SophBG/pi-tin-mod/3d/faceplate/faceplate_preview.png

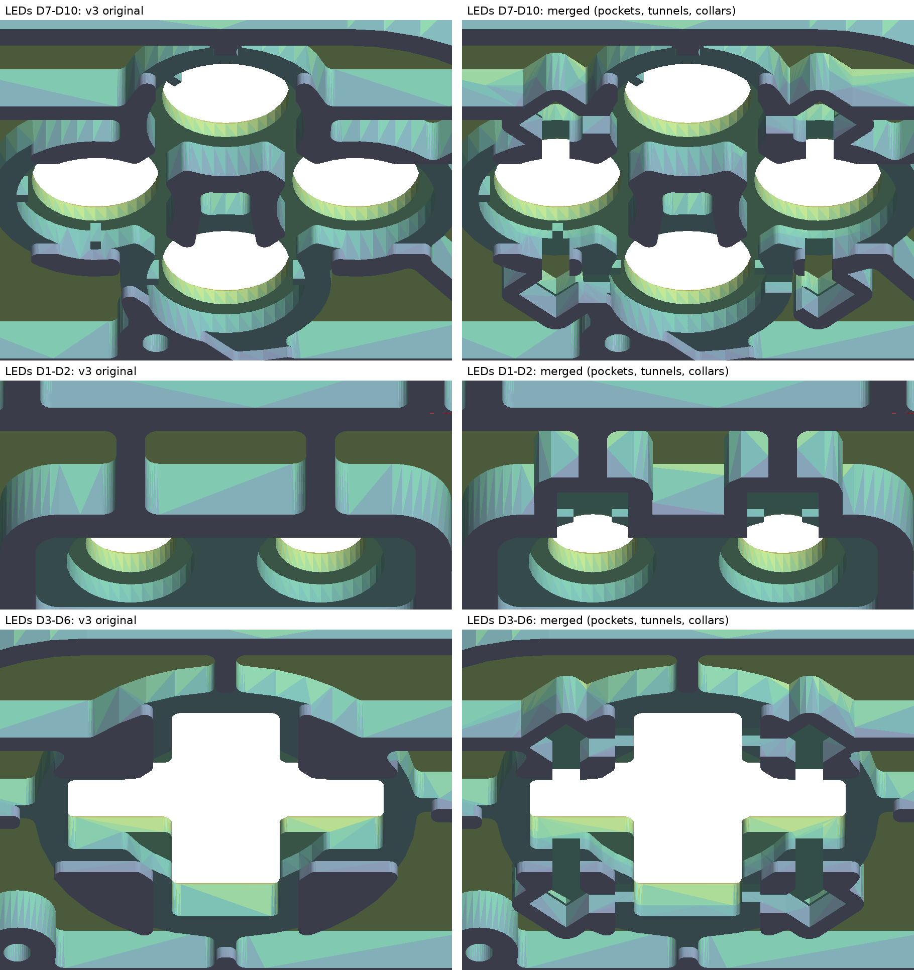
3d/faceplate/faceplate_preview.png
