SophBG/pi-tin-mod/images/variant_comparison.png

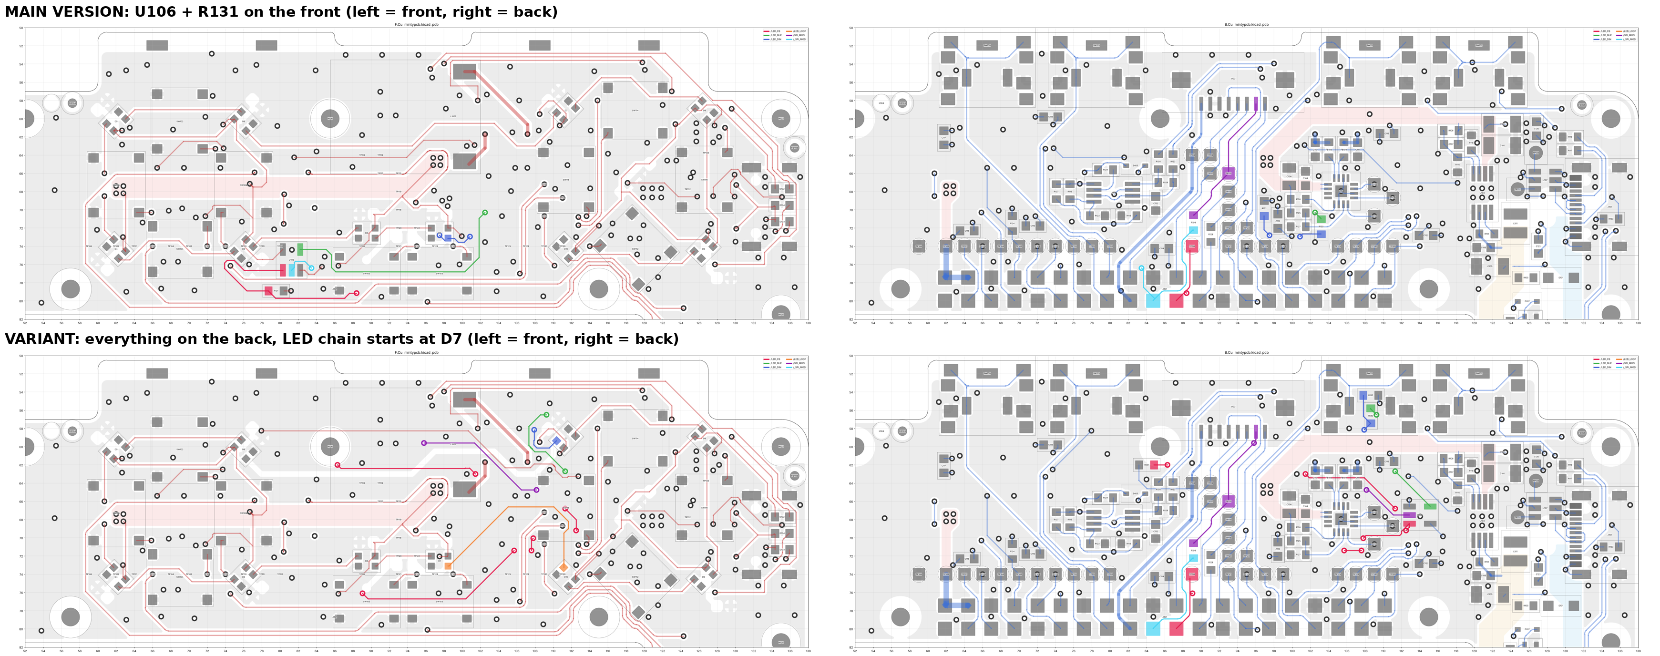
images/variant_comparison.png
