SophBG/pi-tin-mod/software/orange_pi/overlay/ask-card-en.png

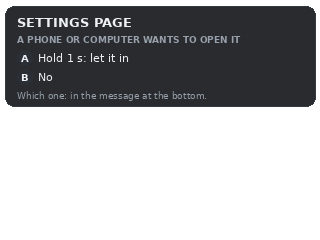
software/orange_pi/overlay/ask-card-en.png
