SophBG/pi-tin-mod/software/orange_pi/overlay/ask-card-fr.png

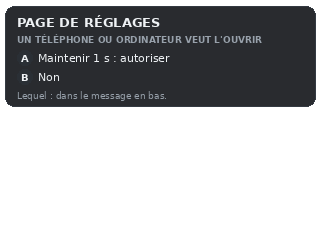
software/orange_pi/overlay/ask-card-fr.png
