SophBG/pi-tin-mod/software/orange_pi/overlay/help-card-en.png

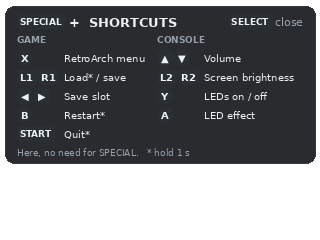
software/orange_pi/overlay/help-card-en.png
