SophBG/pi-tin-mod/software/orange_pi/overlay/help-card-fr.png

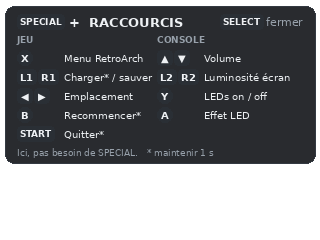
software/orange_pi/overlay/help-card-fr.png
