SophBG/pi-tin-mod/bom/1_set/BOM_comparison.csv

Item | Description | References (per board) | Qty needed (1 set) | LCSC: code (MPN) | LCSC: qty to order | LCSC: total € | LCSC: note | Mouser FR: code (MPN) | Mouser: qty to order | Mouser: total € | Mouser: note | DigiKey FR: code (MPN) | DigiKey: qty to order | DigiKey: total € | DigiKey: note
C22u | Ceramic capacitor 22 µF 10 V X7R 1206 | C101,C102,C105 | 3 | C87996 (CL31B226KPHNNNE) | 5 | 0.76 |  | 187-CL31B226KPHNNNE (CL31B226KPHNNNE) | 3 | 1.29 |  | 1276-2769-1-ND (CL31B226KPHNNNE) | 3 | 1.34
C10u | Ceramic capacitor 10 µF X7R 0805 (≥10 V) | C103,C104,C108 + display C101 | 4 | C32635 (CL21B106KPQNNNE) | 10 | 0.83 |  | 187-CL21B106KPQNNNG (CL21B106KPQNNNG) | 4 | 1.17 | same capacitor as the schematic (the NNNE packaging is out of stock at Mouser) | 1276-2872-1-ND (CL21B106KOQNNNE) | 4 | 0.97 | 16 V version of the same capacitor (the 10 V one is out of stock)
C100n | Ceramic capacitor 100 nF 50 V X7R 0603 | C106,C109,C112,C113-C122 | 13 | C14663 (CC0603KRX7R9BB104) | 50 | 0.55 |  | 603-CC603KRX7R9BB104 (CC0603KRX7R9BB104) | 13 | 0.82 |  | 399-C0603C104K5RACTUCT-ND (C0603C104K5RACTU) | 13 | 0.90 | direct equivalent (the YAGEO part is out of stock at DigiKey)
WS2812 | Addressable RGB LED, 2020 size, WS2812B-2020 compatible (2×2 mm) | D1-D10 | 10 | C5349955 (XL-2020RGBC-WS2812B) | 10 | 1.00 | Worldsemi WS2812B-2020 (C965555) is no longer available; same pinout (DO, GND, DI, VDD), 2.0×2.0×0.65 mm, 5 mA per colour | 485-4684 (4684) | 1 | 3.40 | pack of 10 WS2812B-2020 LEDs | 1528-4684-ND (4684) | 1 | 3.53 | pack of 10 WS2812B-2020 LEDs
D101 | Schottky diode 100 V 1 A SOD-123F | D101 | 1 | C64888 (DSK110) | 50 | 0.86 |  | 771-PMEG10010ELRX (PMEG10010ELRX) | 1 | 0.39 | 100 V 1 A, lower Vf; SOD-123W (CFP3) body fits the SOD-123F pads | MBR1H100SFT3GOSCT-ND (MBR1H100SFT3G) | 1 | 0.59 | 100 V 1 A, SOD-123FL (same pads)
LEDor | Orange LED 0603 | D102 | 1 | C157740 (LTST-C190KFKT) | 50 | 0.88 |  | 859-LTST-C190KFKT (LTST-C190KFKT) | 1 | 0.12 |  | 160-1434-1-ND (LTST-C190KFKT) | 1 | 0.13
LEDgr | Green LED 0603 | D104 | 1 | C364559 (LTST-C190TGKT) | 20 | 0.75 |  | 859-LTST-C190TGKT (LTST-C190TGKT) | 1 | 0.39 |  | 160-2019-1-ND (LTST-C190TGKT) | 1 | 0.40
BAT54 | Schottky diode BAT54WS 30 V SOD-323 | D105,D106,D107 | 3 | C124205 (BAT54WS-7-F) | 10 | 0.57 |  | 621-BAT54WS-F (BAT54WS-7-F) | 3 | 0.57 |  | BAT54WS-TPCT-ND (BAT54WS-TP) | 3 | 0.46 | same BAT54WS SOD-323 (the Diodes Inc. part is out of stock)
F101 | SMD fuse 1 A fast-acting 0603 | F101 | 1 | C151139 (0467001.NRHF) | 10 | 0.46 |  | 504-CC06FA1A-TR (CC06FA1A-TR) | 1 | 0.30 | 1 A 63 V fast-acting 0603; 1/4 of the Littelfuse price (1.34 €) | SF-0603F100-2CT-ND (SF-0603F100-2) | 1 | 0.82 | 1 A fast-acting 0603; half the Littelfuse price ($1.81)
USBC | USB-C receptacle 16 pins SMD (USB 2.0) | J101 | 1 | C2894897 (HC-TYPE-C-16P-01A) | 5 | 0.38 |  | 640-USB4105-GF-A (USB4105-GF-A) | 1 | 0.69 | fits the adapted board directly (pitin_extra footprint accepts HCTL and GCT) | 2073-USB4105-GF-ACT-ND (USB4105-GF-A) | 1 | 0.72 | fits the adapted board directly (pitin_extra footprint accepts HCTL and GCT)
JST | JST PH 2-pin SMD side-entry connector (battery) | J102 | 1 | C295747 (S2B-PH-SM4-TB(LF)(SN)) | 5 | 1.07 |  | 306-S2BPHSM4KTBLFSN (S2B-PH-SM4-K-TB(LF)(SN)) | 1 | 0.47 | same connector with black housing (the beige one is out of stock until 13/10) | 455-S2B-PH-SM4-TBCT-ND (S2B-PH-SM4-TB(LF)(SN)) | 1 | 0.44
FPC8 | FPC connector 8 pos 1.0 mm pitch, bottom contact (inter-board cable) | J103 + display J102 | 2 | C19269923 (FPC09-Q1.0-8AH2.0) | 5 | 0.39 |  | 538-200528-0080 (200528-0080) | 2 | 1.03 | same body as the XYECONN; fits the adapted board directly (tab pads widened) | WM17815CT-ND (2005280080) | 2 | 1.20 | same body as the XYECONN; fits the adapted board directly (tab pads widened)
FPC50 | FPC connector 50 pos 0.5 mm pitch, top contact, slide lock (display panel) | display J103 | 1 | C262650 (AFC07-S50ECA-00) | 5 | 1.30 |  | 649-F32Q-1A7H1-11050 (F32Q-1A7H1-11050) | 1 | 2.00 | same type (top contact, 2.0 mm high); pins line up and the tabs land inside the pads | 609-F32Q-1A7H1-11050CT-ND (F32Q-1A7H1-11050) | 1 | 2.08 | same type (top contact, 2.0 mm high); pins line up and the tabs land inside the pads
L101 | Inductor 2.2 µH 3.2×2.5 mm (1210), Isat ≥ 3 A | L101 | 1 | C5832385 (FTC322512S2R2MBCA) | 5 | 1.36 |  | 81-DFE322512F-2R2MP2 (DFE322512F-2R2M=P2) | 1 | 0.42 | same 3225×1.2 mm size | 490-DFE322512F-2R2M=P2CT-ND (DFE322512F-2R2M=P2) | 1 | 0.44 | same 3225×1.2 mm size
Q3415 | P-channel MOSFET 20 V ~4 A SOT-23 (AO3415A type) | Q101,Q102 | 2 | C133233 (AO3415A) | 5 | 0.47 | the "3415A" in the schematic (C337518) is discontinued; AO3415A is the original part | 621-DMG3415U-7 (DMG3415U-7) | 2 | 0.89 | equivalent (20 V, 4 A, 42 mΩ); Mouser does not sell the AO3415A | 4518-AO3415ACT-ND (AO3415A) | 2 | 0.86
BSS138 | N-channel MOSFET BSS138W SOT-323 | Q103 | 1 | C24553 (BSS138W-7-F) | 5 | 1.21 |  | 771-BSS138BKW115 (BSS138BKW,115) | 1 | 0.28 | 60 V SOT-323 equivalent (Diodes BSS138W out of stock; Mouser does not sell the MCC one in France) | BSS138W-TPMSCT-ND (BSS138W-TP) | 1 | 0.23
NMOS_disp | N-channel MOSFET 20 V SOT-323, logic level (backlight) | display Q101 | 1 | C110101 (CJ3134KW) | 20 | 0.59 |  | 621-DMN2004WK-7 (DMN2004WK-7) | 1 | 0.49 | equivalent: 20 V 0.54 A, Vgs(th) ≤ 1 V | DMN2004WKDICT-ND (DMN2004WK-7) | 1 | 0.51 | equivalent: 20 V 0.54 A, Vgs(th) ≤ 1 V
R10k | Resistor 10 kΩ 1% 0603 | R101,R111,R121,R131 + display R104 | 5 | C98220 (RC0603FR-0710KL) | 100 | 0.30 | the UNI-ROYAL C25804 is out of stock | 603-RC0603FR-0710KL (RC0603FR-0710KL) | 10 | 0.12 |  | 311-10.0KHRCT-ND (RC0603FR-0710KL) | 10 | 0.22
R22 | Resistor 22 Ω 1% 0603 | R104,R128 | 2 | C23345 (0603WAF220JT5E) | 100 | 0.15 |  | 603-RC0603FR-0722RL (RC0603FR-0722RL) | 10 | 0.10 |  | RMCF0603FT22R0CT-ND (RMCF0603FT22R0) | 2 | 0.18
R1k69 | Resistor 1.69 kΩ 1% 0603 | R105,R110,R114,R120 | 4 | C22846 (0603WAF1691T5E) | 100 | 0.43 |  | 603-RC0603FR-071K69L (RC0603FR-071K69L) | 10 | 0.12 |  | 311-1.69KHRCT-ND (RC0603FR-071K69L) | 10 | 0.22
R100k | Resistor 100 kΩ 1% 0603 | R106,R112,R113,R115,R122,R127,R129,R132,R133,R134 | 10 | C25803 (0603WAF1003T5E) | 100 | 0.28 |  | 603-RC0603FR-07100KL (RC0603FR-07100KL) | 10 | 0.12 |  | 311-100KHRCT-ND (RC0603FR-07100KL) | 10 | 0.22
R49k9 | Resistor 49.9 kΩ 1% 0603 | R107 | 1 | C23184 (0603WAF4992T5E) | 100 | 0.73 |  | 603-RC0603FR-0749K9L (RC0603FR-0749K9L) | 1 | 0.09 |  | 311-49.9KHRCT-ND (RC0603FR-0749K9L) | 1 | 0.09
R750k | Resistor 750 kΩ 1% 0603 | R108,R126 | 2 | C23240 (0603WAF7503T5E) | 100 | 0.24 |  | 708-RMCF0603FT750K (RMCF0603FT750K) | 10 | 0.10 |  | RMCF0603FT750KCT-ND (RMCF0603FT750K) | 2 | 0.18
R5k1 | Resistor 5.1 kΩ 1% 0603 | R116,R117,R123,R124 | 4 | C23186 (0603WAF5101T5E) | 100 | 0.13 |  | 603-RC0603FR-075K1L (RC0603FR-075K1L) | 10 | 0.15 |  | RMCF0603FT5K10CT-ND (RMCF0603FT5K10) | 10 | 0.19
R68k | Resistor 68 kΩ 1% 0603 | R119 | 1 | C23231 (0603WAF6802T5E) | 100 | 0.14 |  | 603-RC0603FR-0768KL (RC0603FR-0768KL) | 1 | 0.09 |  | 311-68.0KHRCT-ND (RC0603FR-0768KL) | 1 | 0.09
R330 | Resistor 330 Ω 1% 0603 | R130 | 1 | C23138 (0603WAF3300T5E) | 100 | 0.23 |  | 603-RC0603FR-07330RL (RC0603FR-07330RL) | 1 | 0.09 |  | 311-330HRCT-ND (RC0603FR-07330RL) | 1 | 0.09
R10 | Resistor 10 Ω 1% 0603 | display R101,R102,R103,R105 | 4 | C22859 (0603WAF100JT5E) | 20 | 0.06 |  | 708-RMCF0603FT10R0 (RMCF0603FT10R0) | 10 | 0.10 |  | RMCF0603FT10R0CT-ND (RMCF0603FT10R0) | 10 | 0.19
SKQG | Tactile switch Alps SKQGABE010 5.2×5.2 mm | SW101,SW103,SW105,SW115 | 4 | C115351 (SKQGABE010) | 5 | 0.56 |  | 688-SKQGAB (SKQGABE010) | 4 | 1.34 |  | 4809-SKQGABE010CT-ND (SKQGABE010) | 4 | 1.11
SKRR | Tactile switch Alps SKRRAAE010 (D-pad, ABXY) | SW102,SW104,SW106,SW108,SW110,SW112,SW114,SW116 | 8 | C97437 (SKRRAAE010) | 10 | 1.56 |  | 688-SKRRAA (SKRRAAE010) | 8 | 4.66 |  | 4809-SKRRAAE010CT-ND (SKRRAAE010) | 8 | 4.08
TL3336 | Side-actuated tactile switch E-Switch TL3336AF160Q (shoulder buttons, 3D printed case) | SW107,SW109,SW111,SW113 | 4 | C2979165 (TL3336AF160Q) | 4 | 2.09 |  | 612-TL3336AF160Q (TL3336AF160Q) | 4 | 1.48 |  | 141-TL3336AF160QCT-ND (TL3336AF160Q) | 4 | 1.68
LMV393 | Dual comparator LMV393 MSOP-8 | U101 | 1 | C460091 (LMV393M8-13) | 5 | 1.32 |  | 621-LMV393M8-13 (LMV393M8-13) | 1 | 0.33 |  | LMV393M8-13DICT-ND (LMV393M8-13) | 1 | 0.36
MCP73833 | Li-Po charger MCP73833-FCI DFN-10 3×3 | U102 | 1 | C511320 (MCP73833-FCI/MF) | 1 | 1.99 | same IC in a tube; the tape-and-reel version (C511337) is out of stock | 579-MCP73833T-FCI/MF (MCP73833T-FCI/MF) | 1 | 0.98 |  | MCP73833T-FCI/MFCT-ND (MCP73833T-FCI/MF) | 1 | 1.02
PAM2401 | Boost converter PAM2401SCADJ MSOP-8 | U103 | 1 | C508238 (PAM2401SCADJ) | 1 | 0.67 |  | 621-PAM2401SCADJ (PAM2401SCADJ) | 1 | 0.92 |  | PAM2401SCADJDICT-ND (PAM2401SCADJ) | 1 | 1.06
MAX98357 | I2S class-D amplifier MAX98357A TQFN-16 | U104 | 1 | C910544 (MAX98357AETE+T) | 1 | 1.19 |  | 700-MAX98357AETE+T (MAX98357AETE+T) | 1 | 3.51 |  | MAX98357AETE+TCT-ND (MAX98357AETE+T) | 1 | 3.65
AHCT125 | Buffer 74AHCT1G125 SOT-23-5 (LED data) | U106 | 1 | C7484 (SN74AHCT1G125DBVR) | 5 | 0.45 |  | 595-SNAHCT1G125DBVR (SN74AHCT1G125DBVR) | 1 | 0.12 |  | 296-4708-1-ND (SN74AHCT1G125DBVR) | 1 | 0.13
USBLC6 | ESD protection USBLC6-2SC6 SOT-23-6 | U107 | 1 | C7519 (USBLC6-2SC6) | 5 | 0.80 |  | 511-USBLC6-2SC6 (USBLC6-2SC6) | 1 | 0.42 |  | 497-5235-1-ND (USBLC6-2SC6) | 1 | 0.48
APX803 | Reset supervisor 3.08 V SOT-23 (display) | display U101 | 1 | C460552 (APX803-31SAG-7) | 5 | 1.03 |  | 621-APX803S-31SA-7 (APX803S-31SA-7) | 1 | 0.23 | newer version of the same IC (3.08 V, 240 ms) | APX803S-31SA-7DICT-ND (APX803S-31SA-7) | 1 | 0.29 | newer version of the same IC (3.08 V, 240 ms)
FFC | FFC cable 8 pos 1.0 mm pitch, 50 mm, contacts on the same side | extra: cable between the boards | 1 | C2857570 (JS10A-08P-050-4-8) | 5 | 0.40 | same type as the GCT: 1.0 mm, 8 pos, 5 cm, contacts on the same side | 640-1008A0050C4084T (10-08-A-0050-C-4-08-4-T) | 1 | 0.64 |  | 2073-10-08-A-0050-C-4-08-4-T-ND (10-08-A-0050-C-4-08-4-T) | 1 | 0.66
SPK | Speaker 15×11×2.5 mm 8 Ω 0.7 W, spring contacts (no soldering) | extra: LS101 | 1 | — |  |  | not available | 490-CMS-151125078S67 (CMS-151125-078S-67) | 1 | 2.17 | 8 Ω version of the original (6 Ω): same body, same spring contacts | 102-4998-ND (CMS-151125-078S-67) | 1 | 2.72 | 8 Ω version of the original (6 Ω): same body, same spring contacts
LCD | Display 2.8" TFT 240×320 ILI9341, 50-pin 0.5 mm FPC, resistive touch | extra: display panel | 1 | — |  |  | not available | 485-1774 (1774) | 1 | 15.44 | the panel of the original design (Multi-Inno MI0283QT-11) | — |  |  | not available
TOTAL (parts only, no shipping/taxes) |  |  |  |  |  | 28.18 |  |  |  | 48.02 |  |  |  | 34.50
