SophBG/pi-tin-mod/bom/1_set/BOM_Mouser_FR_speaker_display_only.csv

Mouser Part Number | Manufacturer Part Number | Manufacturer | Quantity | Description | Customer Part Number | Designators
490-CMS-151125078S67 | CMS-151125-078S-67 | Same Sky | 1 | Speaker 15×11×2.5 mm 8 Ω 0.7 W, spring contacts (no soldering) | PiTin SPK | extra: LS101
485-1774 | 1774 | Adafruit | 1 | Display 2.8" TFT 240×320 ILI9341, 50-pin 0.5 mm FPC, resistive touch | PiTin LCD | extra: display panel
