SophBG/pi-tin-mod/3d/case/p101_lower_case_fixed.STL

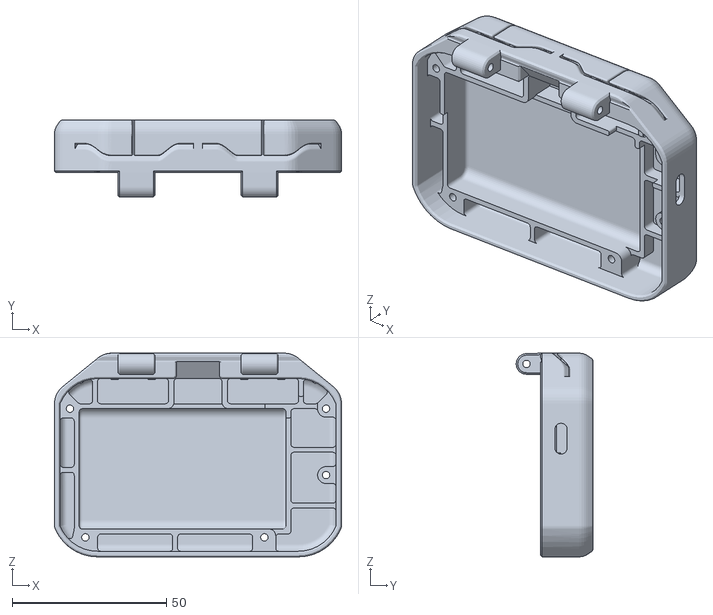
[picture p7: CAD file, 2026-10-13]
3d/case/p101_lower_case_fixed.STL
93.0 x 24.8 x 66.0
