SophBG/pi-tin-mod/3d/faceplate/faceplate_pocket_fill.stl

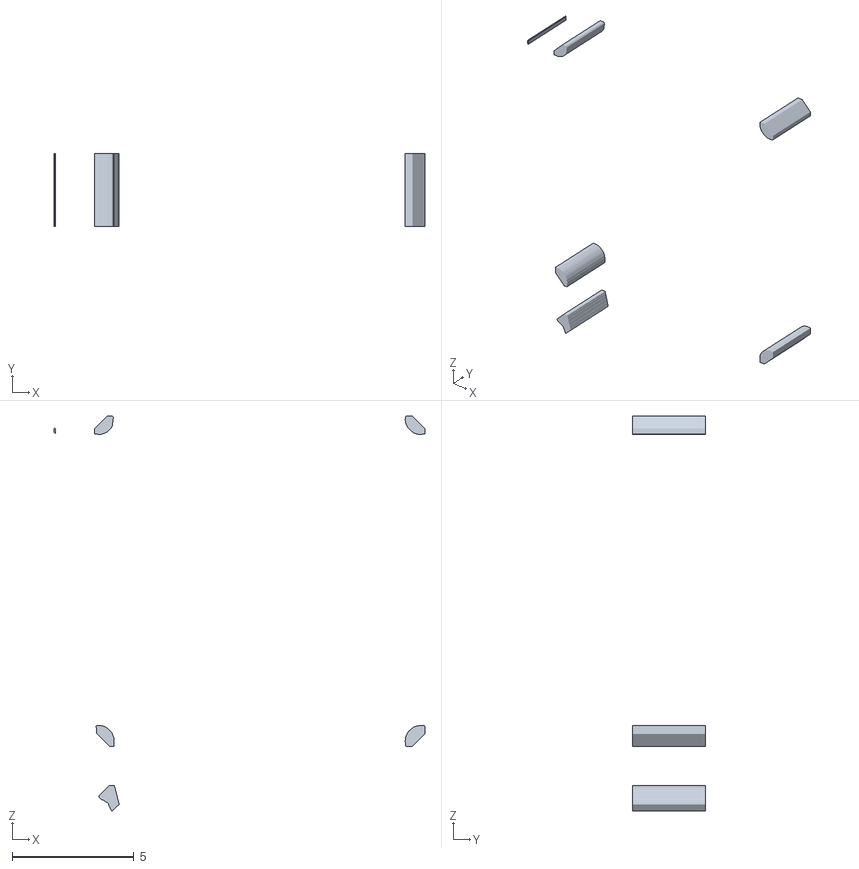
[picture p8: CAD file, 2026-10-17]
3d/faceplate/faceplate_pocket_fill.stl
15.2 x 3.00 x 16.3
