SophBG/pi-tin-mod/3d/faceplate/faceplate_v3_with_led_pockets.stl

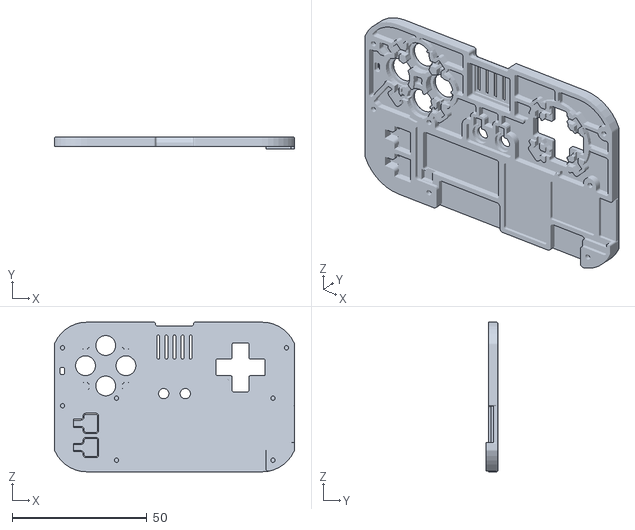
[picture p9: CAD file, 2026-10-17]
3d/faceplate/faceplate_v3_with_led_pockets.stl
89.0 x 4.60 x 55.5
