SophBG/pi-tin-mod/3d/faceplate/faceplate_thickening.stl

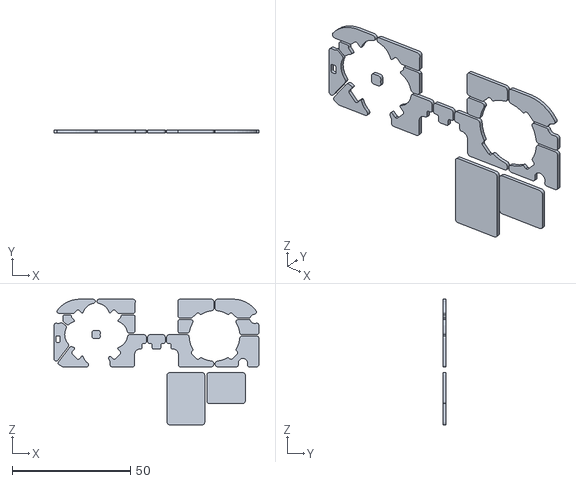
[picture p10: CAD file, 2026-10-17]
3d/faceplate/faceplate_thickening.stl
86.6 x 1.10 x 53.1
