SophBG/pi-tin-mod/3d/faceplate/faceplate_led_collars.stl

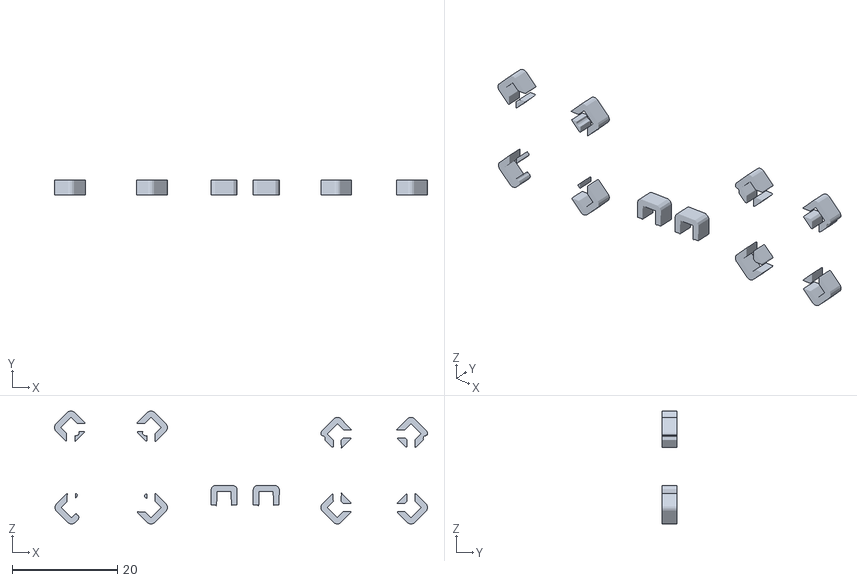
[picture p11: CAD file, 2026-10-13]
3d/faceplate/faceplate_led_collars.stl
70.9 x 2.90 x 21.5
