SophBG/pi-tin-mod/3d/faceplate/v3.stl

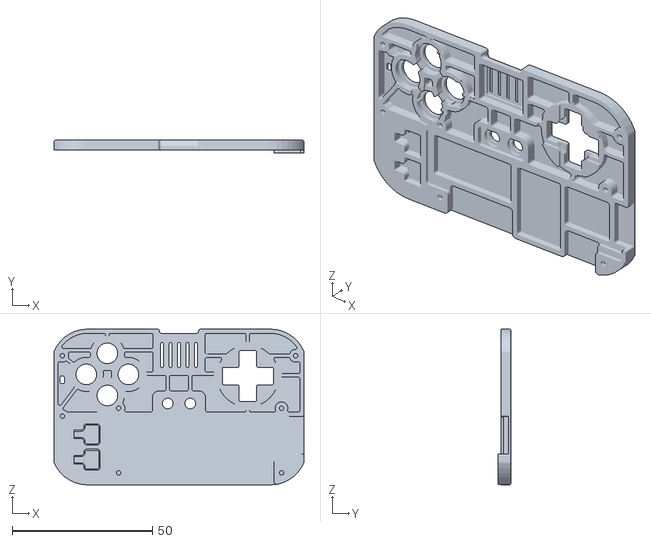
[picture p12: CAD file, 2026-10-13]
3d/faceplate/v3.stl
89.0 x 4.60 x 55.5
