SophBG/pi-tin-mod/3d/faceplate/faceplate_led_cutter.stl

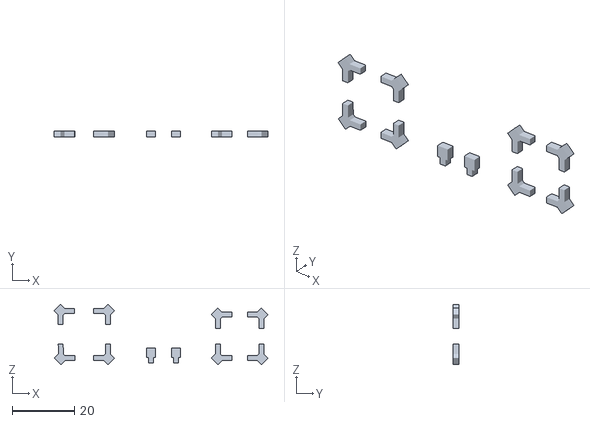
[picture p13: CAD file, 2026-10-13]
3d/faceplate/faceplate_led_cutter.stl
68.8 x 2.00 x 19.4
