SophBG/pi-tin-mod/kicad/pcb_main_r2/mintypcb.kicad_pcb

## KiCad design kicad/pcb_main_r2/mintypcb.kicad_pcb (2026-10-17)

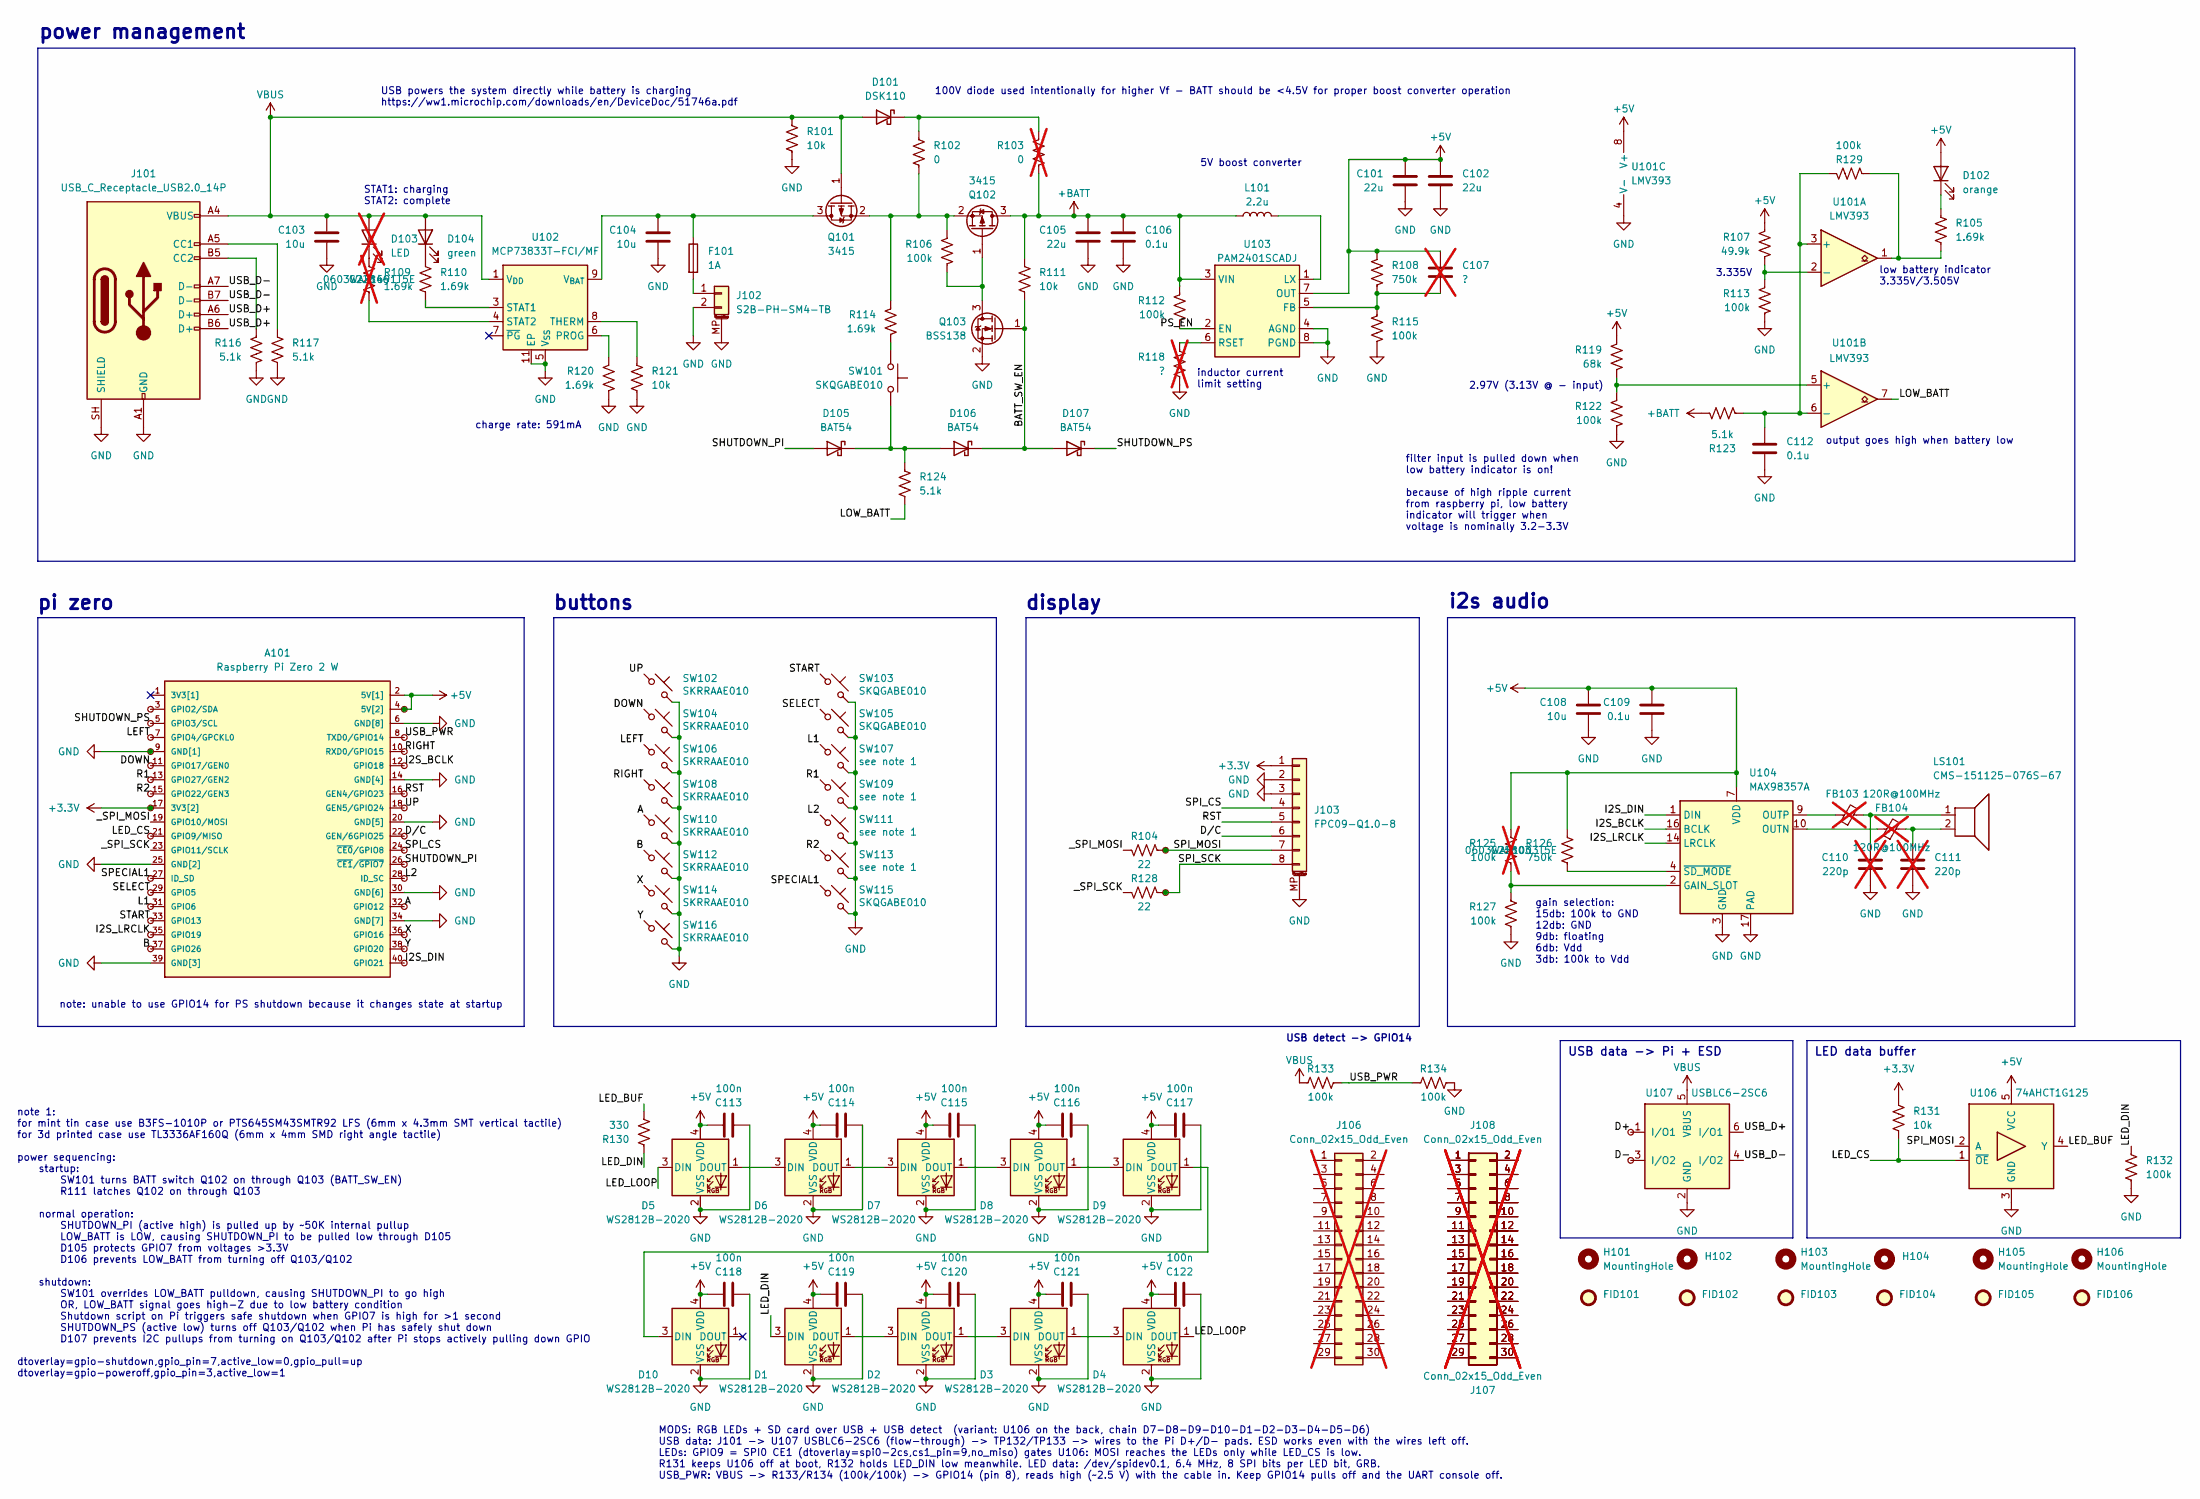
[picture p14: schematic mintypcb.kicad_sch, pi tin main pcb]

Parts:
A101: Raspberry Pi Zero 2 W; RASPBERRYPI-ZERO_RPI-ZERO_pi_tin; MPN (Alternate) SC1176
C101, C102, C105: 22u; C_1206_3216Metric; MPN CL31B226KPHNNNE; LCSC C87996
C103, C104, C108: 10u; C_0805_2012Metric; MPN CL21B106KPQNNNE; LCSC C32635
C106, C109, C112: 0.1u; C_0603_1608Metric; MPN CC0603KRX7R9BB104; LCSC C14663
C107: ?; C_0603_1608Metric; not fitted
C110, C111: 220p; C_0603_1608Metric; MPN (Alternate) CL10C221JB8NNNC; not fitted
C113, C114, C115, C116, C117, C118, C119, C120, C121, C122: 100n; C_0603_1608Metric; MPN CC0603KRX7R9BB104; LCSC C14663
D1, D2, D3, D4, D5, D6, D7, D8, D9, D10: WS2812B-2020; LED_WS2812B-2020_PLCC4_2.0x2.0mm
D101: DSK110; D_SOD-123F; MPN DSK110 K110; LCSC C64888
D102: orange; LED_0603_1608Metric; MPN LTST-C190KFKT; LCSC C157740
D103: LED; LED_0603_1608Metric; not fitted
D104: green; LED_0603_1608Metric; MPN LTST-C190TGKT; LCSC C364559
D105, D106, D107: BAT54; D_SOD-323; MPN BAT54WS-7-F; LCSC C124205
F101: 1A; Fuse_0603_1608Metric; MPN 0467001.NRHF; LCSC C151139
FB103, FB104: 120R@100MHz; R_0603_1608Metric_Bridged; MPN (Alternate) BLM18AG121SZ1D; not fitted
FID101, FID102, FID103, FID104, FID105, FID106: Fiducial_1mm_Mask2mm
H101, H103, H105, H106: MountingHole; MountingHole_2.2mm_M2_Mask_tight
H102, H104: ToolingHole; JLC_tooling_hole
J101: USB_C_Receptacle_USB2.0_14P; USB_C_Receptacle_HCTL_HC-TYPE-C-16P-01A_or_GCT_USB4105-GF-A
J102: S2B-PH-SM4-TB; JST_PH_S2B-PH-SM4-TB_1x02-1MP_P2.00mm_Horizontal; MPN S2B-PH-SM4-TB; LCSC C295747
J103: FPC09-Q1.0-8; FPC_1x08_P1.00mm_XYECONN_FPC09-Q1.0-8AH2.0_or_Molex_200528-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; MPN FPC09-Q1.0-8AH2.0; LCSC C19269923
J106: Conn_02x15_Odd_Even; pi_tin_pi_simulator; not fitted
J107: Conn_02x15_Odd_Even; pi_tin_pi_simulator_lands; not fitted
J108: Conn_02x15_Odd_Even; pi_tin_pi_simulator_tp; not fitted
L101: 2.2u; L_3225DFN; MPN FTC322512S2R2MBCA; LCSC C5832385
LS101: CMS-151125-076S-67; Speaker_CUI_CMR-1206S-67; MPN (Alternate) CMS-151125-076S-67
Q101, Q102: 3415; SOT-23; MPN 3415A; LCSC C337518
Q103: BSS138; SOT-323_SC-70; MPN BSS138W-7-F; LCSC C24553
R101, R111, R121, R131: 10k; R_0603_1608Metric; MPN 0603WAF1002T5E; LCSC C25804
R102: 0; R_0603_1608Metric_Bridged
R103: 0; R_0603_1608Metric; not fitted
R104, R128: 22; R_0603_1608Metric; MPN 0603WAF220JT5E; LCSC C23345
R105, R110, R114, R120: 1.69k; R_0603_1608Metric; MPN 0603WAF1691T5E; LCSC C22846
R106, R112, R113, R115, R122, R127, R129, R132, R133, R134: 100k; R_0603_1608Metric; MPN 0603WAF1003T5E; LCSC C25803
R107: 49.9k; R_0603_1608Metric; MPN 0603WAF4992T5E; LCSC C23184
R108, R126: 750k; R_0603_1608Metric; MPN 0603WAF7503T5E; LCSC C23240
R109: 1.69k; R_0603_1608Metric; MPN 0603WAF1691T5E; LCSC C22846; not fitted
R116, R117, R123, R124: 5.1k; R_0603_1608Metric; MPN 0603WAF5101T5E; LCSC C23186
R118: ?; R_0603_1608Metric; not fitted
R119: 68k; R_0603_1608Metric; MPN 0603WAF6802T5E; LCSC C23231
R125: 100k; R_0603_1608Metric; MPN 0603WAF1003T5E; LCSC C25803; not fitted
R130: 330; R_0603_1608Metric; MPN 0603WAF3300T5E; LCSC C23138
SW101, SW103, SW105, SW115: SKQGABE010; SW_PTS526; MPN SKQGABE010; LCSC C115351
SW102, SW104, SW106, SW108, SW110, SW112, SW114, SW116: SKRRAAE010; SW_SKRR; MPN SKRRAAE010; LCSC C97437
SW107, SW109, SW111, SW113: see note 1; SW_TL3336AF160Q_or_PTS645_paste1; MPN (Alternate) TL3336AF160Q; LCSC C231324
TP101, TP102, TP103, TP104, TP105, TP106, TP107, TP108, TP109, TP110, TP111, TP112, TP113, TP114, TP115, TP116, TP117, TP118, TP119, TP120, TP121, TP122, TP123, TP124, TP125, TP126, TP127, TP128, TP129, TP130, TP131: TestPoint_Small; TestPoint_Pad_D1.5mm
TP132: USB_D+; TestPoint_Pad_D1.5mm
TP133: USB_D-; TestPoint_Pad_D1.5mm
U101: LMV393; MSOP-8_3x3mm_P0.65mm; MPN LMV393M8-13; LCSC C460091
U102: MCP73833T-FCI/MF; DFN-10-1EP_3x3mm_P0.5mm_EP1.58x2.35mm; MPN MCP73833T-FCI/MF; LCSC C511337
U103: PAM2401SCADJ; MSOP-8_3x3mm_P0.65mm; MPN PAM2401SCADJ; LCSC C508238
U104: MAX98357A; TQFN-16-1EP_3x3mm_P0.5mm_EP1.23x1.23mm; MPN MAX98357AETE+T; LCSC C910544
U106: 74AHCT1G125; SOT-23-5; MPN SN74AHCT1G125DBVR; LCSC C7484
U107: USBLC6-2SC6; SOT-23-6; MPN USBLC6-2SC6; LCSC C7519

Connections:
+3.3V: A101.17 (3V3[2]), J103.1, R131.2, TP113.1 (1_1)
+5V: A101.2 (5V[1]), A101.4 (5V[2]), C101.1, C102.1, C107.1, C108.1, C109.1, C113.1, C114.1, C115.1, C116.1, C117.1, C118.1, C119.1, C120.1, C121.1, C122.1, D1.4 (VDD), D2.4 (VDD), D3.4 (VDD), D4.4 (VDD), D5.4 (VDD), D6.4 (VDD), D7.4 (VDD), D8.4 (VDD), D9.4 (VDD), D10.4 (VDD), D102.2 (A), R107.2, R108.1, R119.2, R125.1, R126.1, TP102.1 (1_1), U101.8 (V+), U103.7 (OUT), U104.7 (VDD), U104.8 (VDD), U106.5 (VCC)
+BATT: C105.1, C106.1, L101.1, Q102.3 (D), R103.1, R111.2, R112.2, R123.1, U103.3 (VIN)
/A: A101.32 (GPIO12), SW110.1, TP125.1 (1_1)
/B: A101.37 (GPIO26), SW112.1, TP129.1 (1_1)
/BATT_SW_EN: D106.1 (K), D107.2 (A), Q103.1 (G), R111.1
/D+: TP132.1, U107.1 (I/O1)
/D-: TP133.1, U107.3 (I/O2)
/DOWN: A101.11 (GPIO17/GEN0), SW104.1, TP108.1 (1_1)
/D/C: A101.22 (GEN/6GPIO25), J103.6, TP117.1 (1_1)
/I2S_BCLK: A101.12 (GPIO18), TP109.1 (1_1), U104.16 (BCLK)
/I2S_DIN: A101.40 (GPIO21), TP131.1 (1_1), U104.1 (DIN)
/I2S_LRCLK: A101.35 (GPIO19), TP127.1 (1_1), U104.14 (LRCLK)
/L1: A101.31 (GPIO6), SW107.1, TP124.1 (1_1)
/L2: A101.28 (ID_SC), SW111.1, TP122.1 (1_1)
/LED_BUF: R130.1, U106.4 (Y)
/LED_CS: A101.21 (GPIO9/MISO), R131.1, TP116.1 (1_1), U106.1 (~OE)
/LED_DIN: D1.3 (DIN), R130.2, R132.1
/LED_LOOP: D4.1 (DOUT), D5.3 (DIN)
/LEFT: A101.7 (GPIO4/GPCKL0), SW106.1, TP104.1 (1_1)
/LOW_BATT: R124.1, U101.7
/PS_EN: R112.1, U103.2 (EN)
/R1: A101.13 (GPIO27/GEN2), SW109.1, TP110.1 (1_1)
/R2: A101.15 (GPIO22/GEN3), SW113.1, TP111.1 (1_1)
/RIGHT: A101.10 (RXD0/GPIO15), SW108.1, TP107.1 (1_1)
/SELECT: A101.29 (GPIO5), SW105.1, TP123.1 (1_1)
/SHUTDOWN_PI: A101.26 (~CE1/~GPIO7), D105.2 (A), TP120.1 (1_1)
/SHUTDOWN_PS: A101.5 (GPIO3/SCL), D107.1 (K), TP103.1 (1_1)
/SPECIAL1: A101.27 (ID_SD), SW115.1, TP121.1 (1_1)
/SPI_CS: A101.24 (~CE0/GPIO8), J103.4, TP119.1 (1_1)
/SPI_MOSI: J103.7, R104.1, TP115.1 (1_1), U106.2 (A)
/SPI_SCK: J103.8, R128.1, TP118.1 (1_1)
/START: A101.33 (GPIO13), SW103.1, TP126.1 (1_1)
/USB_D+: J101.A6 (D+), J101.B6 (D+), U107.6 (I/O1)
/USB_D-: J101.A7 (D-), J101.B7 (D-), U107.4 (I/O2)
/USB_PWR: A101.8 (TXD0/GPIO14), R133.2, R134.1, TP105.1 (1_1)
/X: A101.36 (GPIO16), SW114.1, TP128.1 (1_1)
/Y: A101.38 (GPIO20), SW116.1, TP130.1 (1_1)
/_SPI_MOSI: A101.19 (GPIO10/MOSI), R104.2
/_SPI_SCK: A101.23 (GPIO11/SCLK), R128.2
GND: A101.6 (GND[8]), A101.9 (GND[1]), A101.14 (GND[4]), A101.20 (GND[5]), A101.25 (GND[2]), A101.30 (GND[6]), A101.34 (GND[7]), A101.39 (GND[3]), C101.2, C102.2, C103.2, C104.2, C105.2, C106.2, C108.2, C109.2, C110.2, C111.2, C112.2, C113.2, C114.2, C115.2, C116.2, C117.2, C118.2, C119.2, C120.2, C121.2, C122.2, D1.2 (VSS), D2.2 (VSS), D3.2 (VSS), D4.2 (VSS), D5.2 (VSS), D6.2 (VSS), D7.2 (VSS), D8.2 (VSS), D9.2 (VSS), D10.2 (VSS), J101.A1 (GND), J101.A12 (GND), J101.B1 (GND), J101.B12 (GND), J101.SH (SHIELD), J102.2, J102.MP (MountPin), J103.2, J103.3, J103.MP (MountPin), Q103.2 (S), R101.1, R113.1, R115.2, R116.1, R117.1, R118.2, R120.1, R121.1, R122.1, R127.2, R132.2, R134.2, SW102.2, SW103.2, SW104.2, SW105.2, SW106.2, SW107.2, SW108.2, SW109.2, SW110.2, SW111.2, SW112.2, SW113.2, SW114.2, SW115.2, SW116.2, TP106.1 (1_1), U101.4 (V-), U102.5 (V_{SS}), U102.11 (EP), U103.4 (AGND), U103.8 (PGND), U104.3 (GND), U104.11 (GND), U104.15 (GND), U104.17 (PAD), U106.3 (GND), U107.2 (GND)
unnamed: A101.3 (GPIO2/SDA), TP101.1 (1_1)
unnamed: C110.1, FB103.2, LS101.1
unnamed: C111.1, FB104.2, LS101.2
unnamed: D1.1 (DOUT), D2.3 (DIN)
unnamed: D2.1 (DOUT), D3.3 (DIN)
unnamed: D3.1 (DOUT), D4.3 (DIN)
unnamed: D5.1 (DOUT), D6.3 (DIN)
unnamed: D6.1 (DOUT), D7.3 (DIN)
unnamed: D7.1 (DOUT), D8.3 (DIN)
unnamed: D8.1 (DOUT), D9.3 (DIN)
unnamed: D9.1 (DOUT), D10.3 (DIN)
unnamed: D101.1 (K), R102.2, R103.2
unnamed: D102.1 (K), R105.2
unnamed: D103.1 (K), R109.2
unnamed: D104.1 (K), R110.2
unnamed: D105.1 (K), D106.2 (A), R124.2, SW101.1
unnamed: J101.A5 (CC1), R117.2
unnamed: J101.B5 (CC2), R116.2
unnamed: F101.2, J102.1
unnamed: J107.1, J108.1
unnamed: J107.2, J108.2
unnamed: J107.3, J108.3
unnamed: J107.4, J108.4
unnamed: J107.5, J108.5
unnamed: J107.6, J108.6
unnamed: J107.7, J108.7
unnamed: J107.8, J108.8
unnamed: J107.9, J108.9
unnamed: J107.10, J108.10
unnamed: J107.11, J108.11
unnamed: J107.12, J108.12
unnamed: J107.13, J108.13
unnamed: J107.14, J108.14
unnamed: J107.15, J108.15
unnamed: J107.16, J108.16
unnamed: J107.17, J108.17
unnamed: J107.18, J108.18
unnamed: J107.19, J108.19
unnamed: J107.20, J108.20
unnamed: J107.21, J108.21
unnamed: J107.22, J108.22
unnamed: J107.23, J108.23
unnamed: J107.24, J108.24
unnamed: J107.25, J108.25
unnamed: J107.26, J108.26
unnamed: J107.27, J108.27
unnamed: J107.28, J108.28
unnamed: J107.29, J108.29
unnamed: J107.30, J108.30
unnamed: C104.1, F101.1, Q101.3 (D), U102.9 (V_{BAT}), U102.10 (V_{BAT})
unnamed: Q101.2 (S), Q102.2 (S), R102.1, R106.2, R114.2
unnamed: Q102.1 (G), Q103.3 (D), R106.1
unnamed: R105.1, R129.2, U101.1
unnamed: R114.1, SW101.2
unnamed: C112.1, R123.2, R129.1, U101.3 (+), U101.6 (-)
unnamed: R107.1, R113.2, U101.2 (-)
unnamed: R119.1, R122.2, U101.5 (+)
unnamed: R120.2, U102.6 (PROG)
unnamed: R110.1, U102.3 (STAT1)
unnamed: R109.1, U102.4 (STAT2)
unnamed: R121.2, U102.8 (THERM)
unnamed: C107.2, R108.2, R115.1, U103.5 (FB)
unnamed: L101.2, U103.1 (LX)
unnamed: R118.1, U103.6 (RSET)
unnamed: R125.2, R127.1, U104.2 (GAIN_SLOT)
unnamed: FB104.1, U104.10 (OUTN)
unnamed: FB103.1, U104.9 (OUTP)
unnamed: R126.2, U104.4 (~SD_MODE)
VBUS: C103.1, D101.2 (A), D103.2 (A), D104.2 (A), J101.A4 (VBUS), J101.A9 (VBUS), J101.B4 (VBUS), J101.B9 (VBUS), Q101.1 (G), R101.2, R133.1, U102.1 (V_{DD}), U102.2 (V_{DD}), U107.5 (VBUS)

Notes on the sheet:
i2s audio
low battery indicator 3.335V/3.505V
2.97V (3.13V @ - input)
USB powers the system directly while battery is charging https://ww1.microchip.com/downloads/en/DeviceDoc/51746a.pdf
note: unable to use GPIO14 for PS shutdown because it changes state at startup
5V boost converter
display
pi zero
note 1: for mint tin case use B3FS-1010P or PTS645SM43SMTR92 LFS (6mm x 4.3mm SMT vertical tactile) for 3d printed case use TL3336AF160Q (6mm x 4mm SMD right angle tactile) power sequencing: startup: SW101 turns BATT switch Q102 on through Q103 (BATT_SW_EN) R111 latches Q102 on through Q103 normal 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
3.335V
power management
filter input is pulled down when low battery indicator is on! because of high ripple current from raspberry pi, low battery indicator will trigger when voltage is nominally 3.2-3.3V
output goes high when battery low
charge rate: 591mA
buttons
STAT1: charging STAT2: complete
inductor current limit setting
100V diode used intentionally for higher Vf - BATT should be <4.5V for proper boost converter operation
gain selection: 15db: 100k to GND 12db: GND 9db: floating 6db: Vdd 3db: 100k to Vdd
USB data -> Pi + ESD
LED data buffer
USB detect -> GPIO14
MODS: RGB LEDs + SD card over USB + USB detect (variant: U106 on the back, chain D7-D8-D9-D10-D1-D2-D3-D4-D5-D6) USB data: J101 -> U107 USBLC6-2SC6 (flow-through) -> TP132/TP133 -> wires to the Pi D+/D- pads. ESD works even with the wires left off. LEDs: GPIO9 = SPI0 CE1 (dtoverlay=spi0-2cs,cs1_pin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
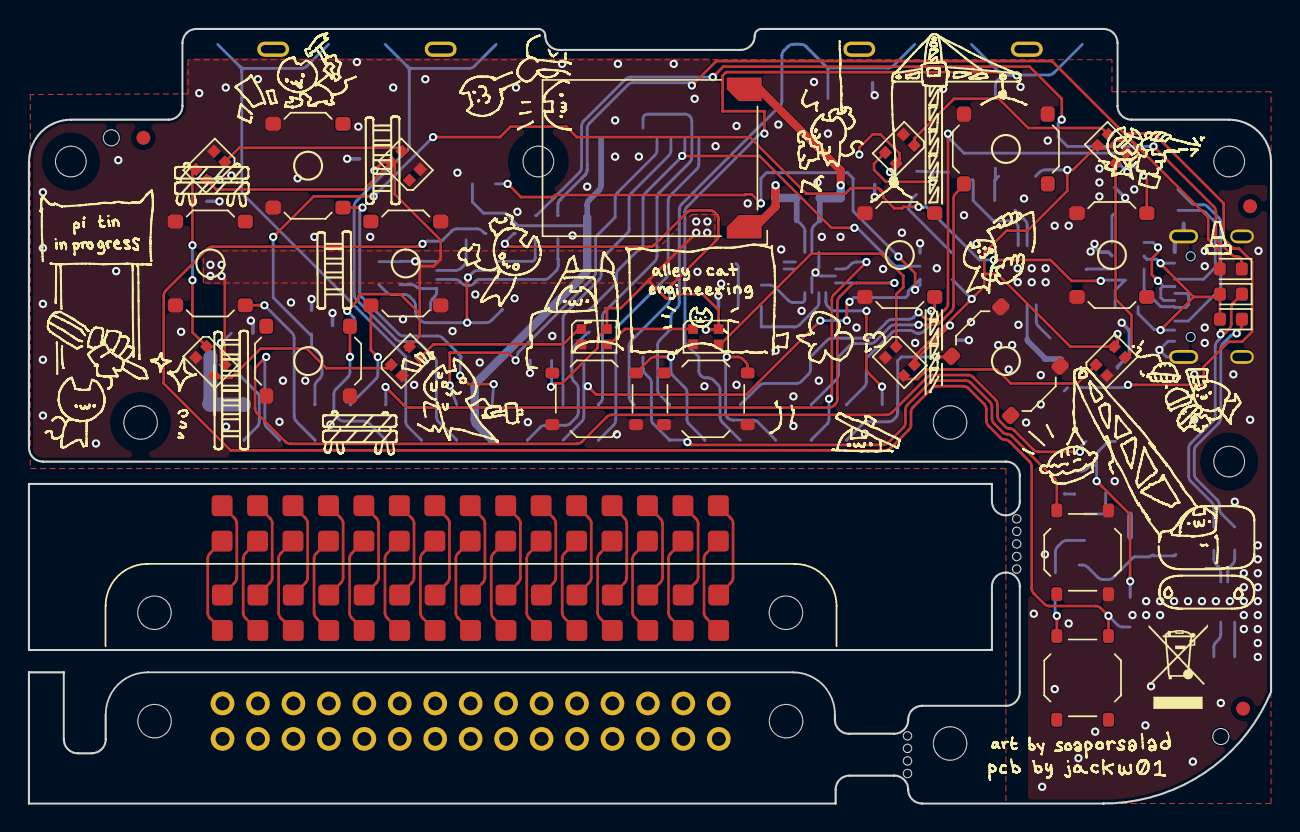
[picture p15: board mintypcb.kicad_pcb from above]

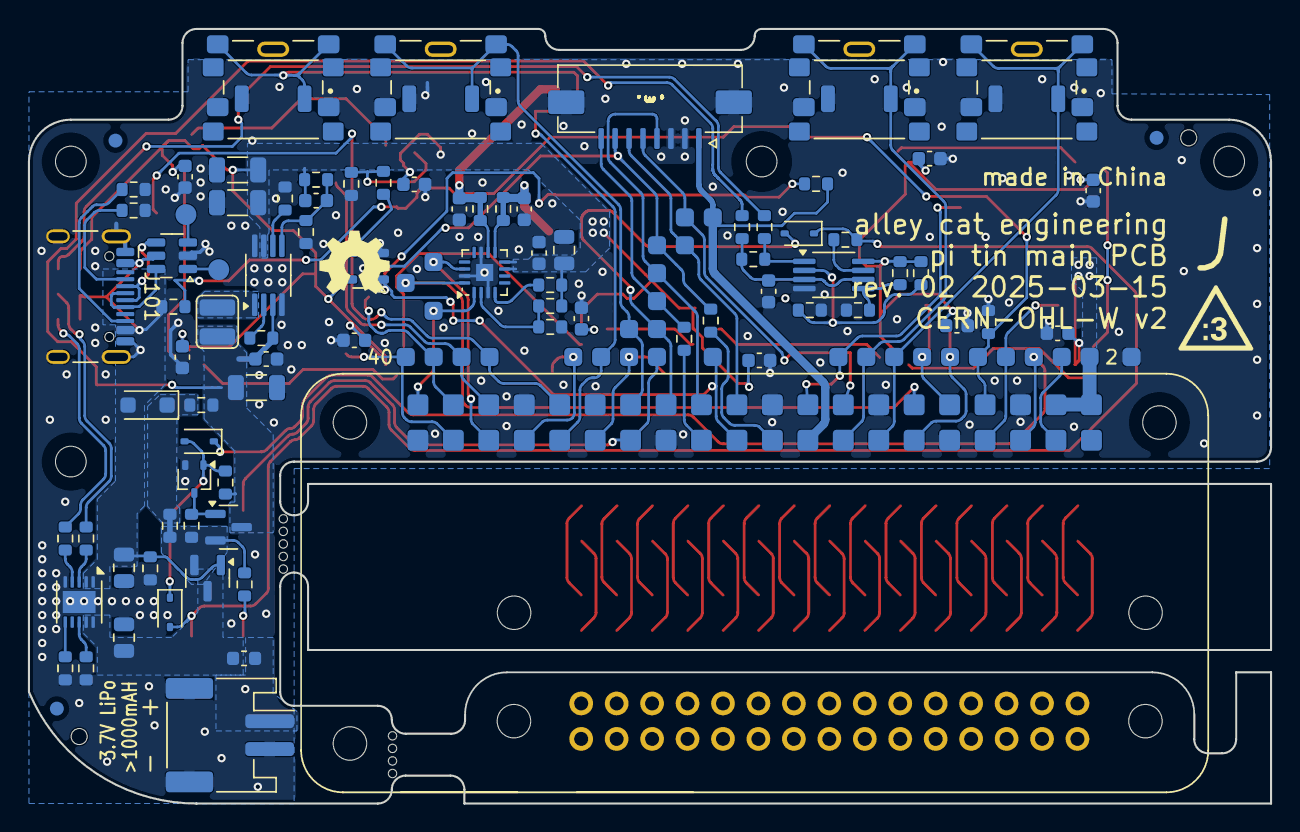
[picture p16: board mintypcb.kicad_pcb from below]

Board: 2 copper layers, 89.0 x 55.5 mm, 155 parts (118 on the bottom side), 112 nets.
