SophBG/pi-tin-mod/kicad/pcb_display_r2a/displaypcb.kicad_pcb

## KiCad design kicad/pcb_display_r2a/displaypcb.kicad_pcb (2026-10-13)

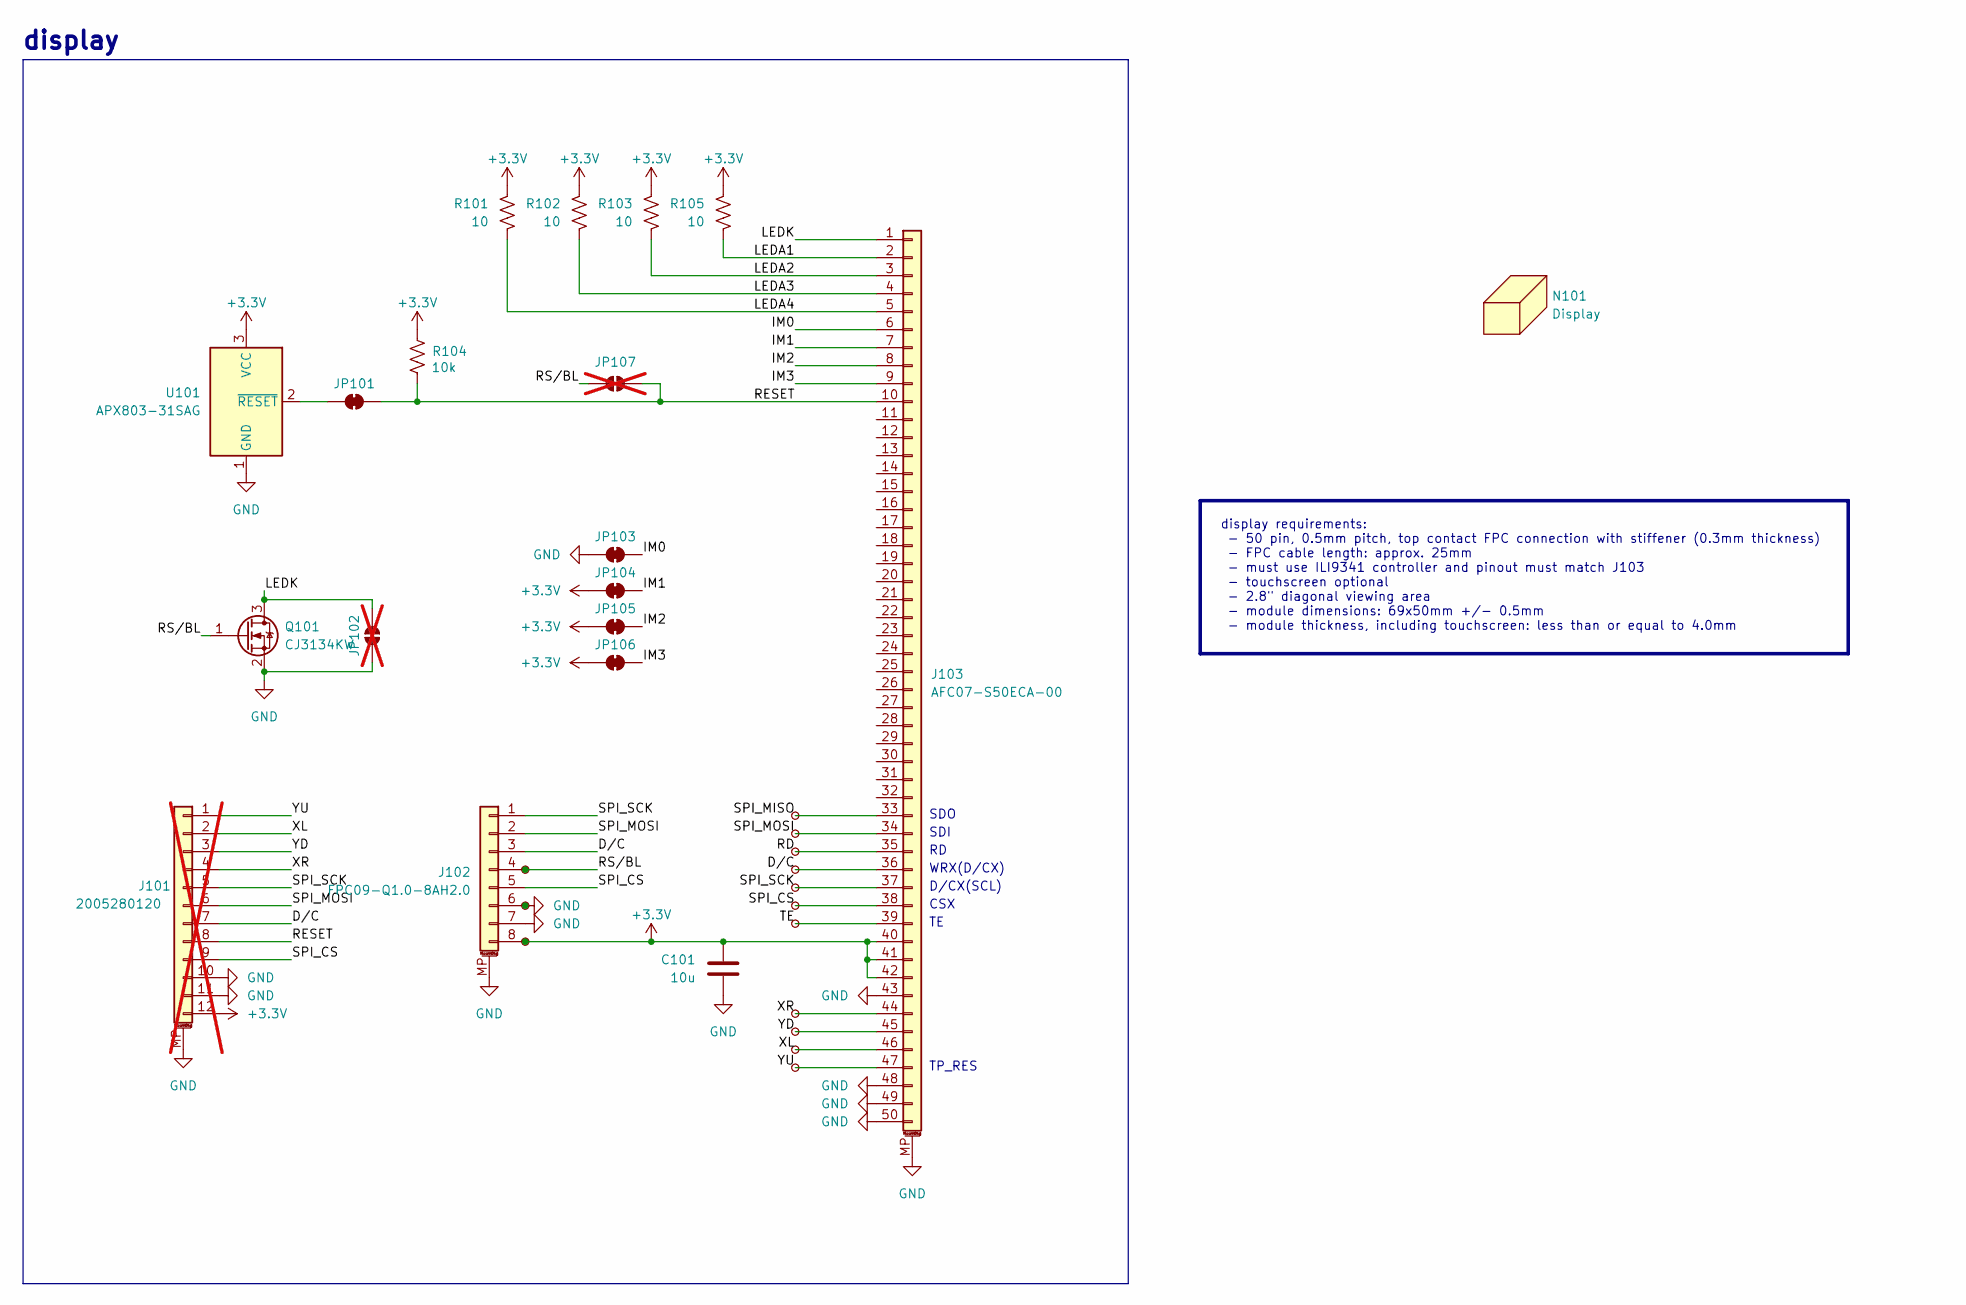
[picture p17: schematic displaypcb.kicad_sch, 2.8in TFT interconnect PCB]

Parts:
C101: 10u; C_0805_2012Metric; MPN CL21B106KPQNNNE; LCSC C32635
J101: 2005280120; Molex_200528-0120_1x12-1MP_P1.00mm_Horizontal; MPN 2005280120; not fitted
J102: FPC09-Q1.0-8AH2.0; FPC_1x08_P1.00mm_XYECONN_FPC09-Q1.0-8AH2.0_or_Molex_200528-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; MPN FPC09-Q1.0-8AH2.0; LCSC C19269923
J103: AFC07-S50ECA-00; Jushuo_AFC07-S50ECA-00; MPN AFC07-S50ECA-00; LCSC C262650
JP101, JP103, JP104, JP105, JP106: SolderJumper_2_Bridged; R_0402_1005Metric_bridged
JP102, JP107: SolderJumper_2_Open; R_0402_1005Metric; not fitted
N101: Display; TFT_2.8in_ILI9341
Q101: CJ3134KW; SOT-323_SC-70; MPN CJ3134KW; LCSC C110101
R101, R102, R103, R105: 10; R_0603_1608Metric; MPN 0603WAF100JT5E; LCSC C22859
R104: 10k; R_0603_1608Metric; MPN 0603WAF1002T5E; LCSC C25804
TP101, TP102, TP103, TP104, TP105, TP106, TP107, TP108, TP109, TP110, TP111, TP112, TP113, TP114: TestPoint_Small; TestPoint_Pad_D1.5mm
U101: APX803-31SAG; SOT-23; MPN APX803-31SAG-7; LCSC C460552

Connections:
+3.3V: C101.1, J101.12, J102.8, J103.40, J103.41, J103.42, JP104.1 (A), JP105.1 (A), JP106.1 (A), R101.2, R102.2, R103.2, R104.1, R105.2, TP102.1, U101.3 (VCC)
/D/C: J101.7, J102.3, J103.36, TP107.1
/IM0: J103.6, JP103.2 (B)
/IM1: J103.7, JP104.2 (B)
/IM2: J103.8, JP105.2 (B)
/IM3: J103.9, JP106.2 (B)
/LEDA1: J103.2, R105.1
/LEDA2: J103.3, R103.1
/LEDA3: J103.4, R102.1
/LEDA4: J103.5, R101.1
/LEDK: J103.1, JP102.2 (B), Q101.3 (D)
/RD: J103.35, TP106.1
/RESET: J101.8, J103.10, JP101.2 (B), JP107.2 (B), R104.2
/RS/BL: J102.4, JP107.1 (A), Q101.1 (G), TP103.1
/SPI_CS: J101.9, J102.5, J103.38, TP109.1
/SPI_MISO: J103.33, TP104.1
/SPI_MOSI: J101.6, J102.2, J103.34, TP105.1
/SPI_SCK: J101.5, J102.1, J103.37, TP108.1
/TE: J103.39, TP110.1
/XL: J101.2, J103.46, TP113.1
/XR: J101.4, J103.44, TP111.1
/YD: J101.3, J103.45, TP112.1
/YU: J101.1, J103.47, TP114.1
GND: C101.2, J101.10, J101.11, J101.MP (MountPin), J102.6, J102.7, J102.MP (MountPin), J103.43, J103.48, J103.49, J103.50, J103.MP (MountPin), JP102.1 (A), JP103.1 (A), Q101.2 (S), TP101.1, U101.1 (GND)
unnamed: JP101.1 (A), U101.2 (~RESET)

Notes on the sheet:
display
CSX
WRX(D/CX)
D/CX(SCL)
SDI
TP_RES
SDO
display requirements: - 50 pin, 0.5mm pitch, top contact FPC connection with stiffener (0.3mm thickness) - FPC cable length: approx. 25mm - must use ILI9341 controller and pinout must match J103 - touchscreen optional - 2.8" diagonal viewing area - module dimensions: 69x50mm +/- 0.5mm - module thic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

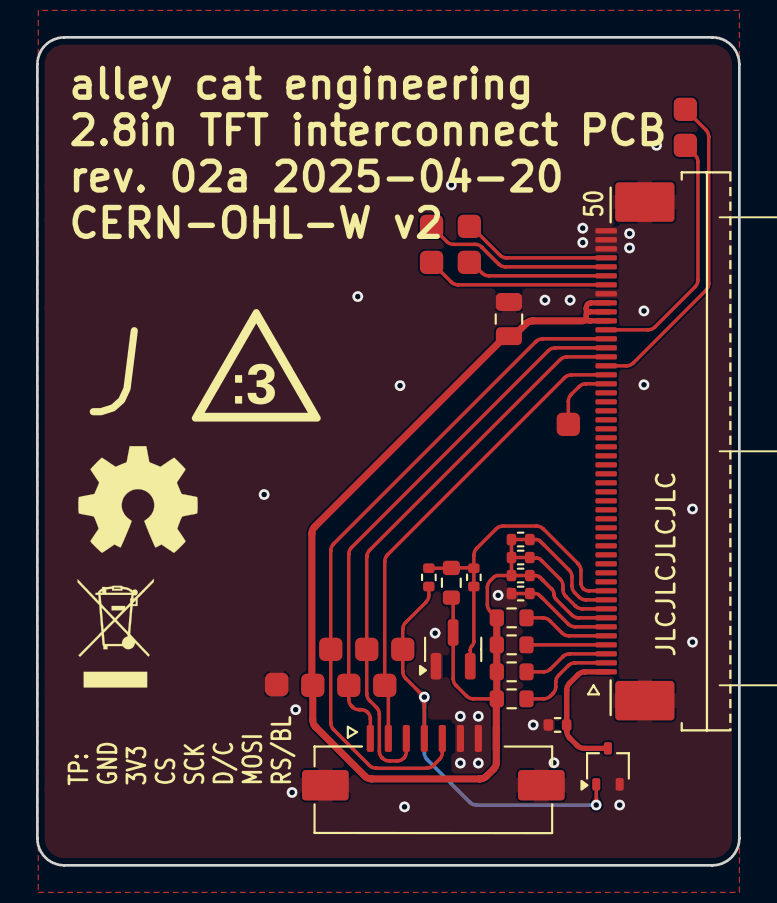
[picture p18: board displaypcb.kicad_pcb from above]

Board: 2 copper layers, 39.0 x 46.0 mm, 32 parts (1 on the bottom side), 25 nets.
