SophBG/pi-tin-mod/(notices)

Notices in the files:
kicad/pcb_display_r2a/displaypcb.kicad_pcb:
Released under the CERN-OHL-W V2 license
